avanegas95/EC450-Microprocessors/EC450_Final_Project/Schematics/Send Schematic.pdf

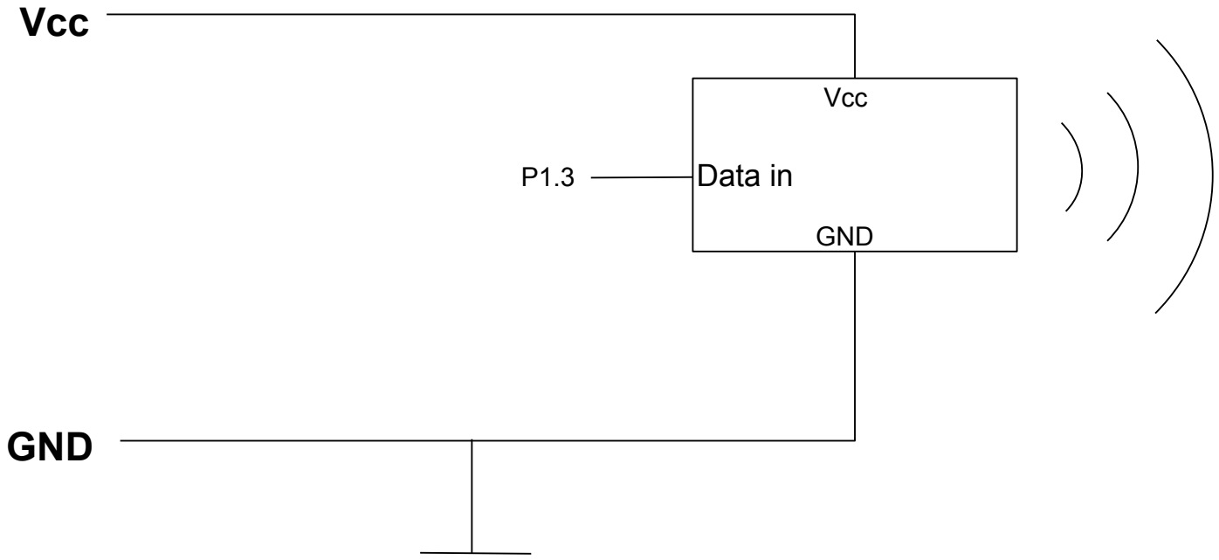
[picture p2: figure]
Data in; Vcc; GND
