avanegas95/EC450-Microprocessors/EC450_Final_Project/Schematics/LCD Schematic.jpg

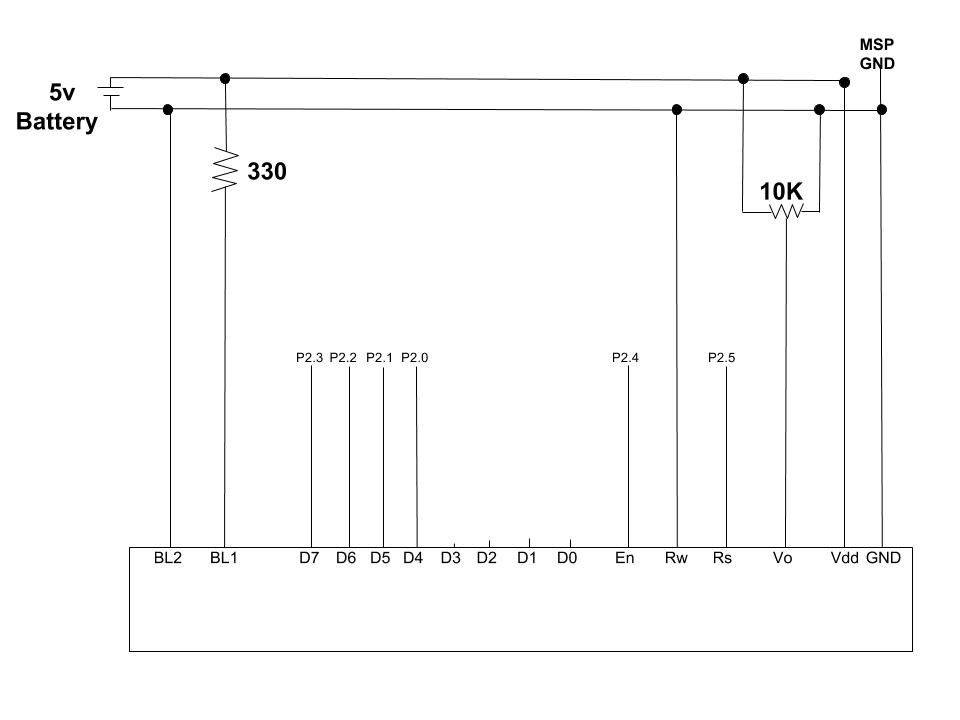
EC450_Final_Project/Schematics/LCD Schematic.jpg
