avanegas95/EC450-Microprocessors/EC450_Final_Project/Schematics/Number Pad Schematic.jpg

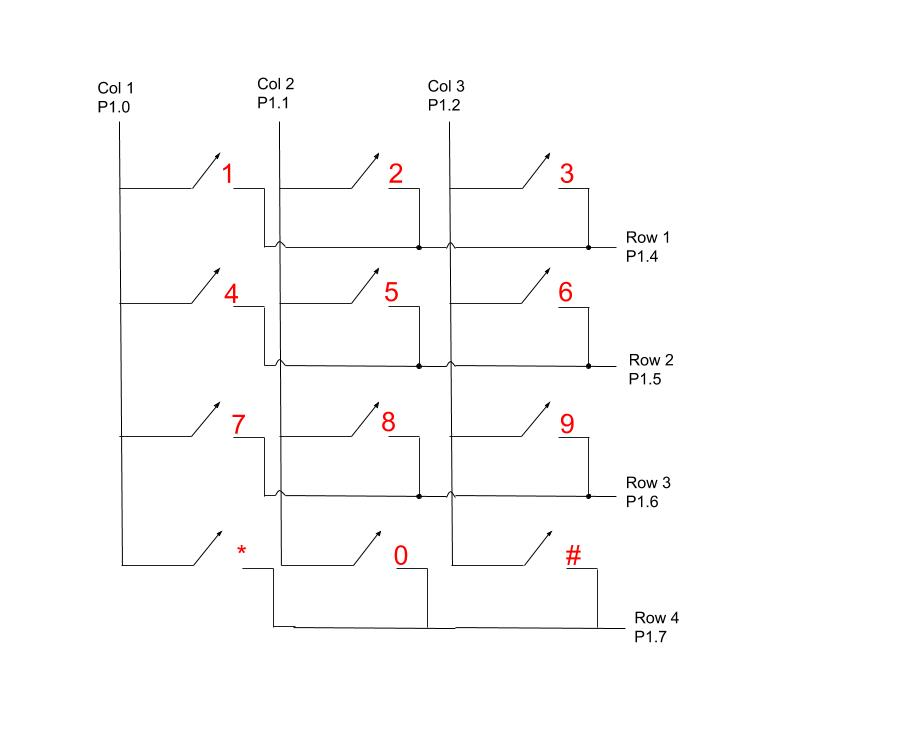
EC450_Final_Project/Schematics/Number Pad Schematic.jpg
