avanegas95/EC450-Microprocessors/EC450_Final_Project/Schematics/Receive Schemeatic.jpg

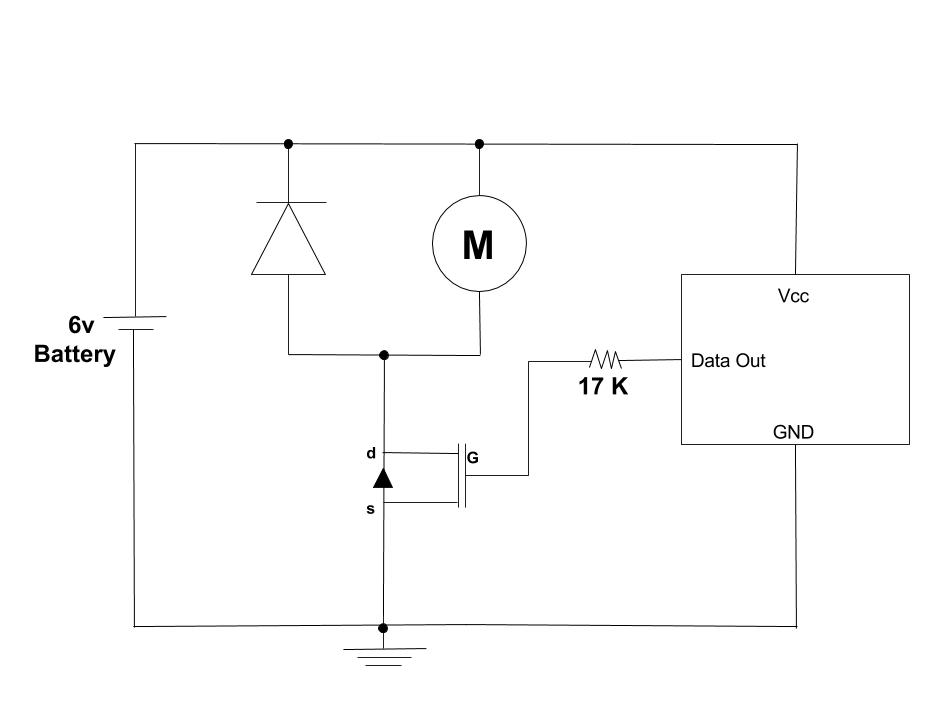
EC450_Final_Project/Schematics/Receive Schemeatic.jpg
