avanegas95/EC450-Microprocessors/EC450_Final_Project/Schematics/Send Schematic.jpg

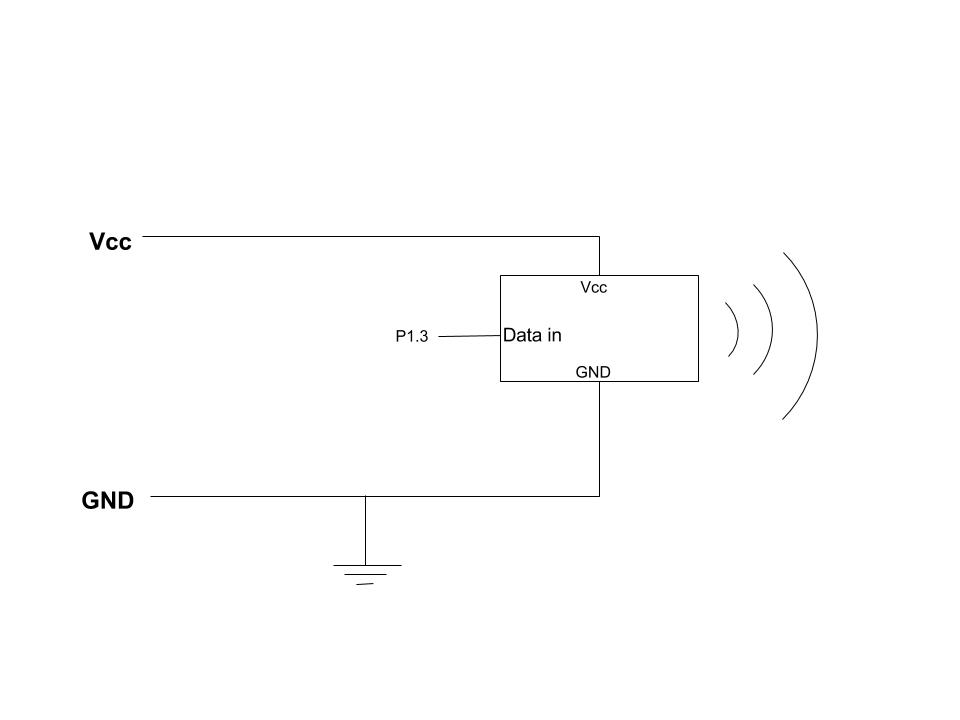
EC450_Final_Project/Schematics/Send Schematic.jpg
