avanegas95/EC450-Microprocessors/EC450_Final_Project/3D Models/cover.stl

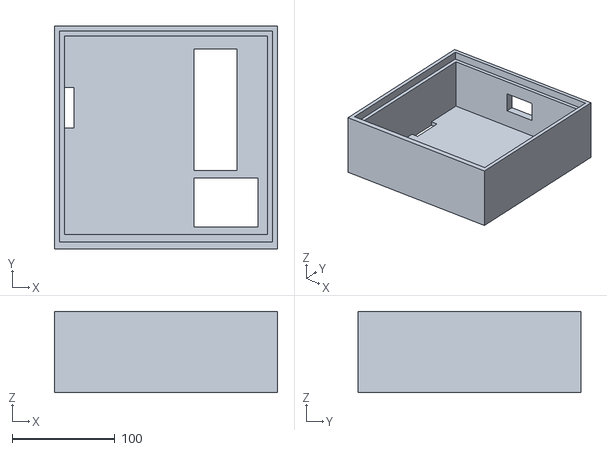
[picture p8: CAD file, 2017-05-04]
EC450_Final_Project/3D Models/cover.stl
216.5 x 216.5 x 78.7
