avanegas95/EC450-Microprocessors/EC450_Final_Project/3D Models/cut_out.stl

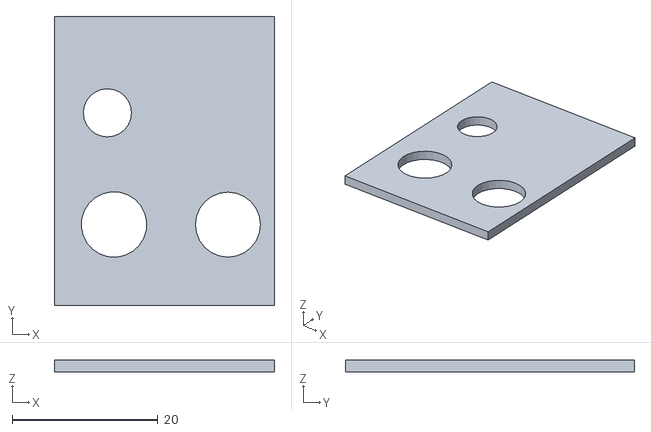
[picture p9: CAD file, 2017-05-04]
EC450_Final_Project/3D Models/cut_out.stl
30.2 x 39.6 x 1.58
