avanegas95/EC450-Microprocessors/EC450_Final_Project/3D Models/lock-base.stl

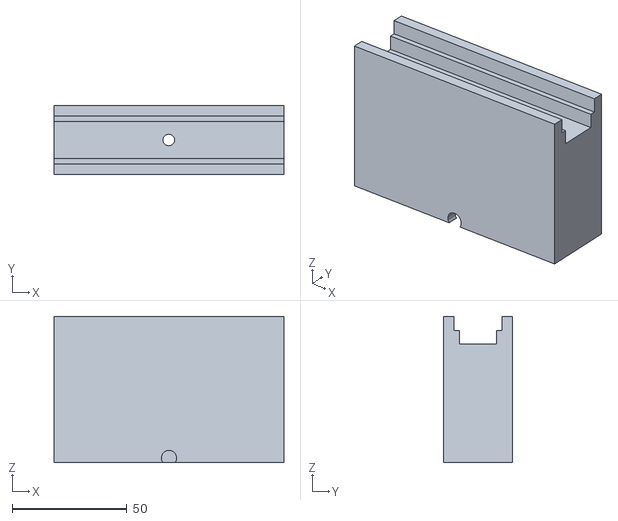
[picture p10: CAD file, 2017-05-04]
EC450_Final_Project/3D Models/lock-base.stl
100.4 x 30.1 x 63.8
