avanegas95/EC450-Microprocessors/EC450_Final_Project/3D Models/motor-cap.stl

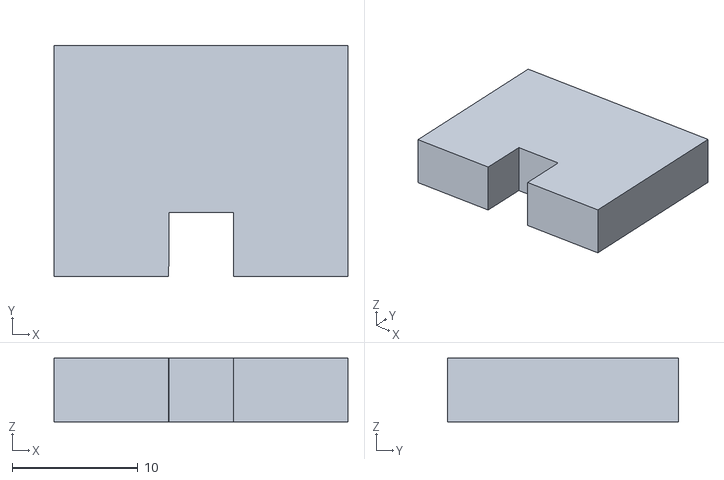
[picture p11: CAD file, 2017-05-04]
EC450_Final_Project/3D Models/motor-cap.stl
23.4 x 18.4 x 5.09
