avanegas95/EC450-Microprocessors/EC450_Final_Project/3D Models/lock-gear-head-v4.stl

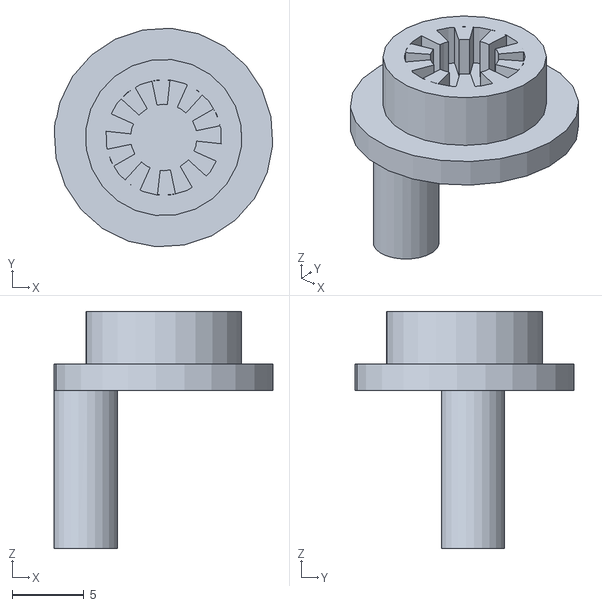
[picture p12: CAD file, 2017-05-04]
EC450_Final_Project/3D Models/lock-gear-head-v4.stl
15.2 x 15.2 x 16.5
