avanegas95/EC450-Microprocessors/EC450_Final_Project/3D Models/lock-gear-arm-v2.stl

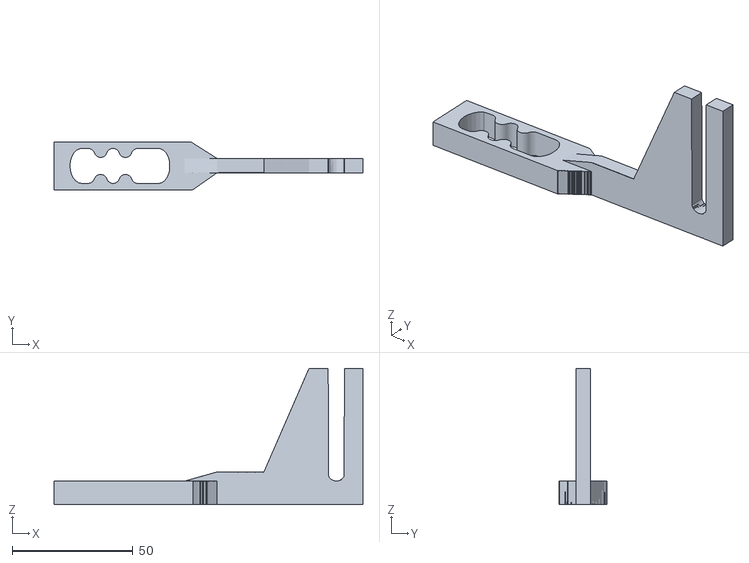
[picture p13: CAD file, 2017-05-04]
EC450_Final_Project/3D Models/lock-gear-arm-v2.stl
127.9 x 19.8 x 56.5
