avanegas95/EC450-Microprocessors/EC450_Final_Project/Schematics/LCD Schematic.pdf

330

5v

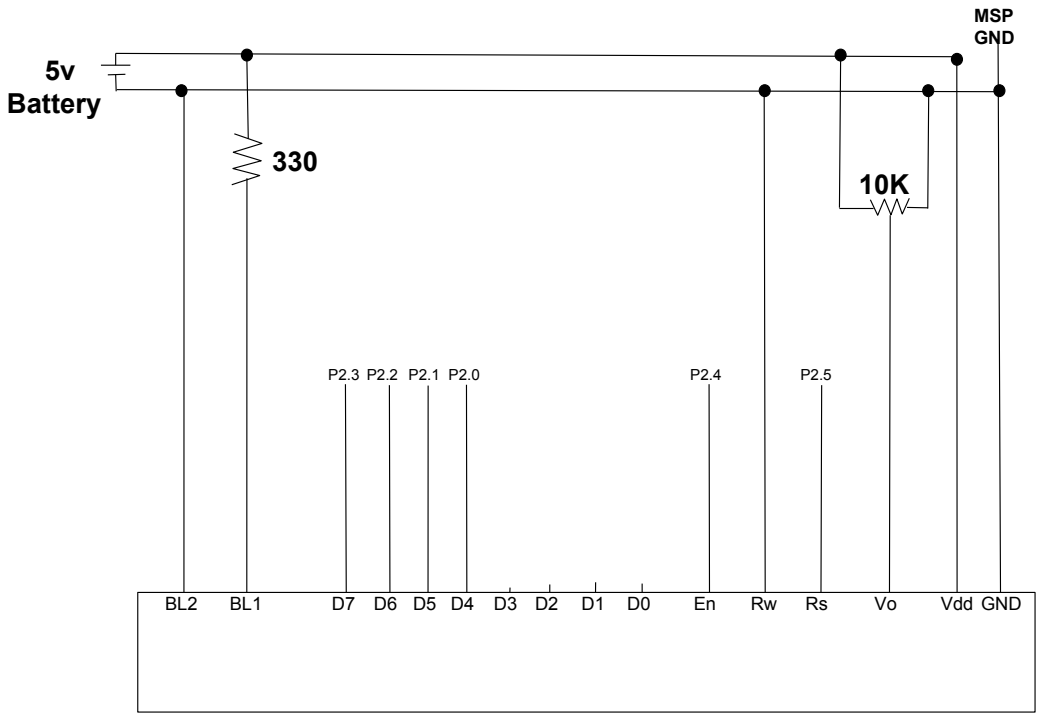
[picture p14: page 1]
