avanegas95/EC450-Microprocessors/EC450_Final_Project/Schematics/Receive Schemeatic.pdf

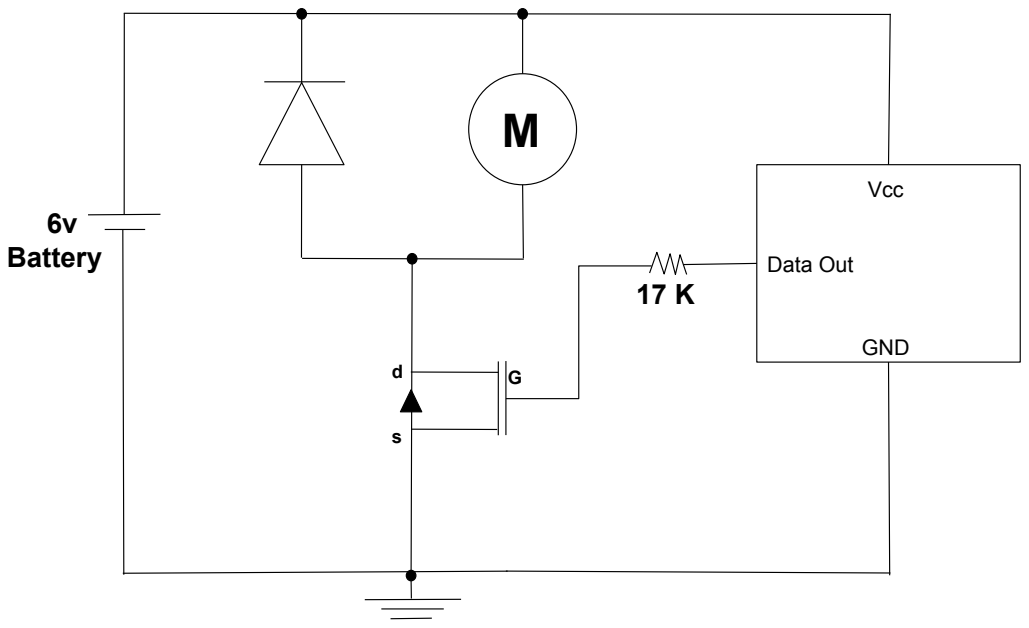
[picture p15: page 1]
6v Battery; Vcc; Data Out; GND
