avanegas95/EC450-Microprocessors/EC450_Final_Project/Schematics/Final Schematic.pdf

# Data

in

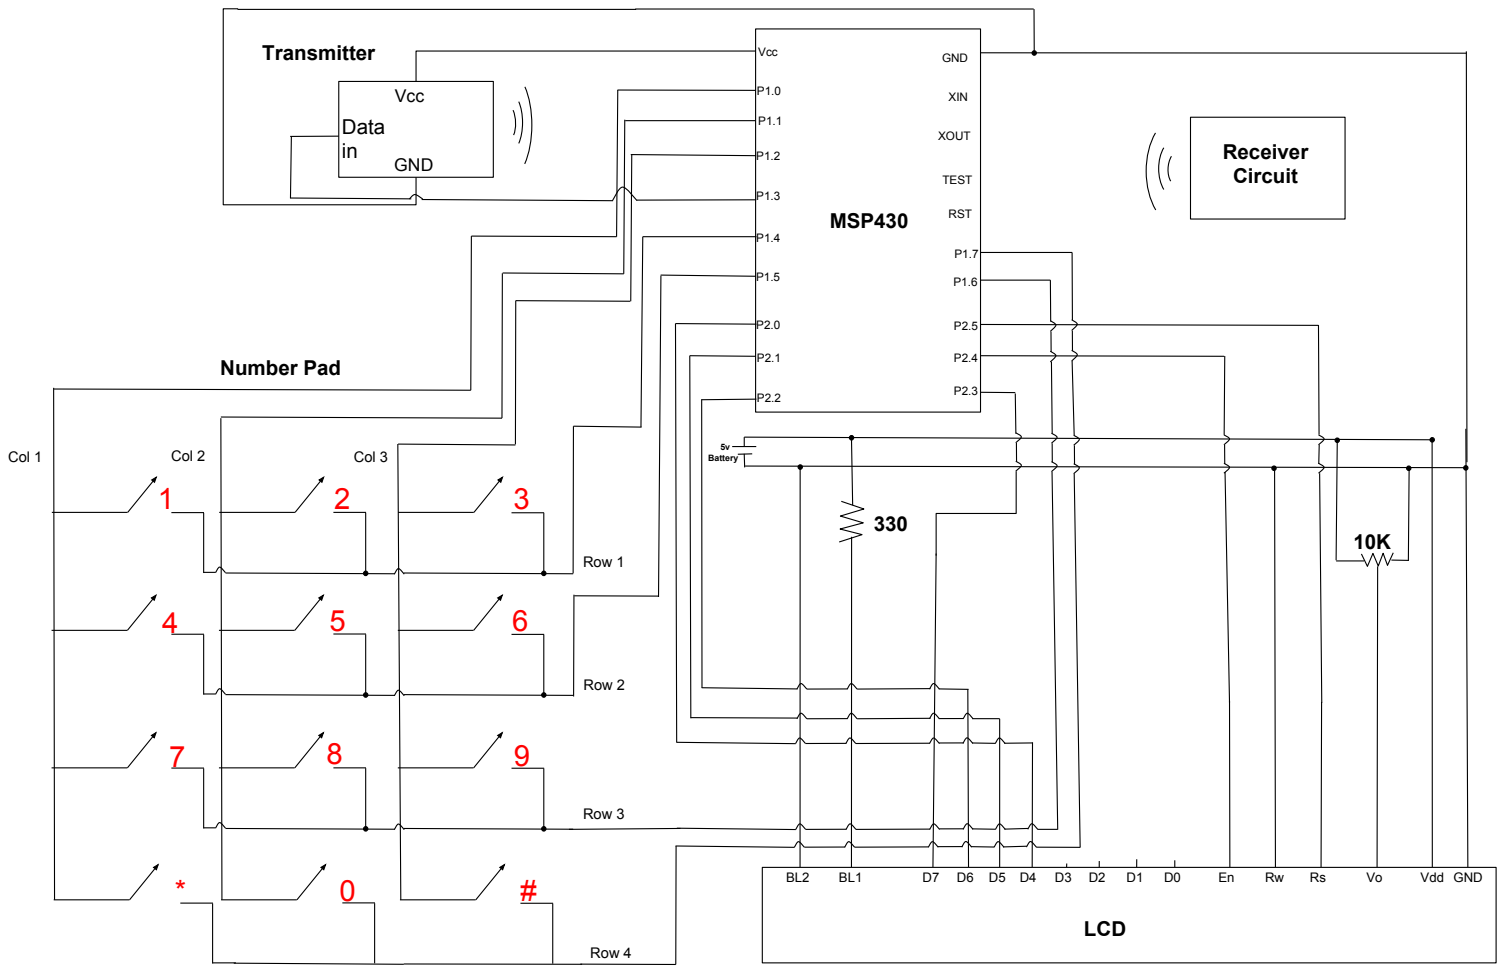
[picture p16: page 1]
