avanegas95/EC450-Microprocessors/EC450_Final_Project/Schematics/Number Pad Schematic.pdf

1 | 2 | 3

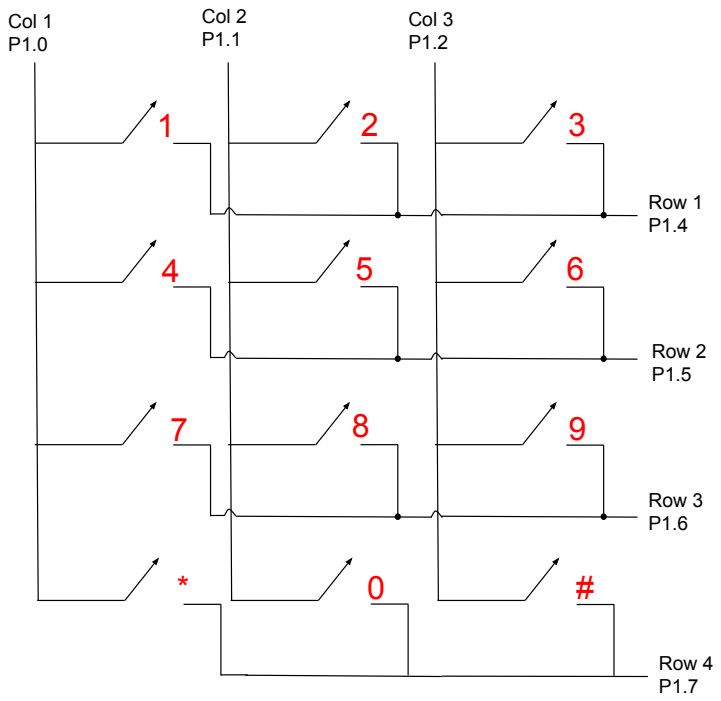
[picture p17: page 1]
Col 1 P1.0; Col 2 P1.1; Col 3 P1.2; Row 1 P1.4; Row 2 P1.5; Row 3 P1.6; Row 4 P1.7
